PranavG200/ATV-BAJA-Team-Kinesis/Drivetrain.pdf

# Drivetrain

The drivetrain of a motor vehicle is the group of components that deliver power to the driving wheels. This excludes the engine that generates power. In contrast, the powertrain is considered to include both the engine and the drivetrain. The function of the drivetrain in a vehicle is to couple the engine that produces the power to the driving wheels that use this mechanical power to rotate the axle.

This connection involves the physical linkage of the two components, which might be at opposite ends of the vehicle hence requiring a long propeller shaft or drive shaft. The operating speed of the engine and wheels are also different and must be matched by the correct gear ratio. As the vehicle speed changes, the ideal engine speed must remain approximately constant for efficient operation and so this gearbox ratio must also be changed, either manually, automatically or by an automatic continuous variation.

Our power train assembly performance, are optimal for our event with maximum speed = 60.3 km/h , and further calculation can show we need the enlisted specifications to achieve the best relation.

Specifications:

Gear Ratio: | 10:1
Power to Mass Ratio : | 0.02 Hp/kg
Max Torque: | 18.57Nm @2600rpm
Max Power: | 7.5Hp@ 3600rpm (considering 25%loss)
Top Speed : | 60.372 kmph acceleration=0.98m/s^2

Inbuilt Locked Differential facilitate different power
requirements & smooth cornering.

Performance Characteristics:
The performance characteristics of BAJA vehicle strongly depends upon four main factors which are:
a.) Gradeability
b.) Top Speed
c.) Acceleration
d.) Reduction in lower gear ratio

Constant value:

For Gradeability:

Gradeability is defined as the ability of a vehicle to climb uphill at a certain angle without the slip occurring. It is an important factor that decides the maximum pulling force that can be applied by the engine on the wheels.

In general sense gradeability is defined in terms of percentage, let say X%. This means that vehicle will cover Xm distance in vertical direction while moving 100 m in a horizontal direction.

For getting an essence of this we try to calculate the variation in traction and various speeds, The following type of drag we need to understand first:

Rolling resistance:=
Rolling resistance is a result of energy loss in the tyre, which can be traced back to the deformation of the area of tyre contact and the damping properties of the rubber. These lead to the transformation of mechanical into thermal energy, contributing to warming of the tyre.

Aerodynamic Resistance:=
Aerodynamic drag of a vehicle is determined by the aerodynamic shape of the body, described by the drag coefficient(Cd), and by the projected frontal area of the vehicle(Af). The aerodynamic force increases with the square of the vehicle's velocity(v).

Grade Resistance:=
Grade resistance is the simplest form of resistance. It is the gravitational force acting on the vehicle. This force may not be exactly perpendicular to the roadway surface, especially in situations when an elevation is present.
Air density(⍴) | =1.12gm/cc
mass(m) (of buggy) | =250kg
Acceleration due to gravity(g) | =9.8m/s^2
Dynamic rolling friction(mr) | =0.085
Air Drag coefficient(cd) | =1.08
Frontal area(Ar) (of buggy) | =0.95m^2

For this calculation, formulae used are listed below:

Rolling resistance:=
mass x acceleration(gravity) x μ(friction coefficient) x Cos(angle of elevation)

Grade resistance:=
mass x acceleration(gravity) x Sin(angle of elevation)

Aerodynamic resistance:=
½ x ⍴(density of air) x A(frontal area) x V

2
(velocity of the buggy) x Cd(drag coefficient)

For calculating grade% of our buggy, we first try to analyze the variation of different speed and different grade%

Rolling resistance:

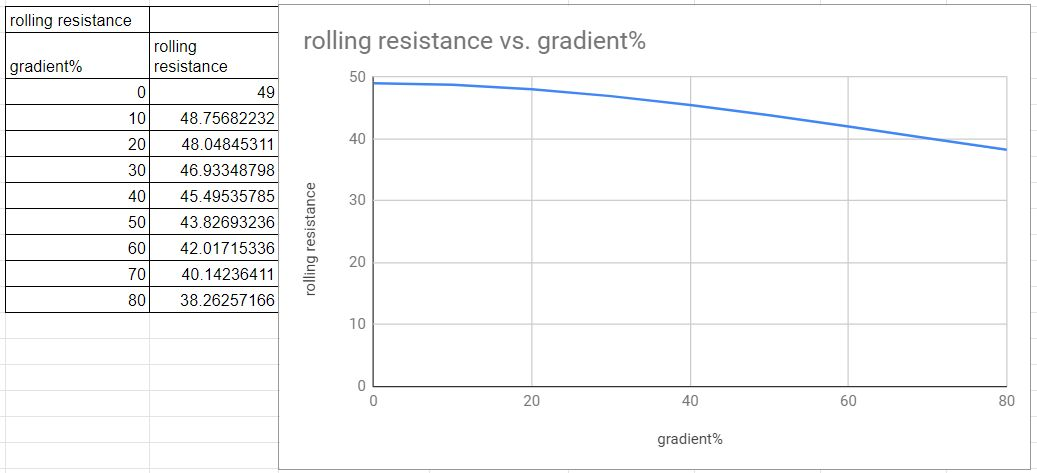
[picture p1: figure]

Gradient resistance:

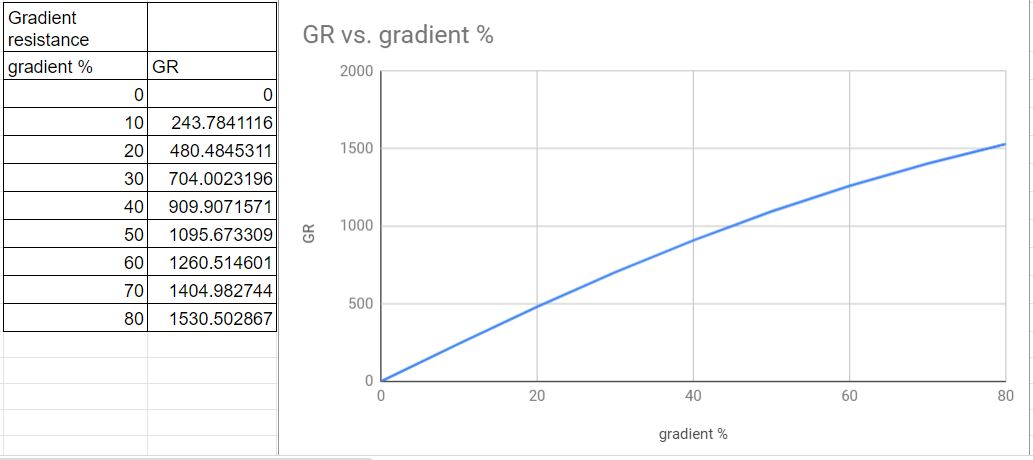
[picture p2: figure]

Aerodynamic resistance:

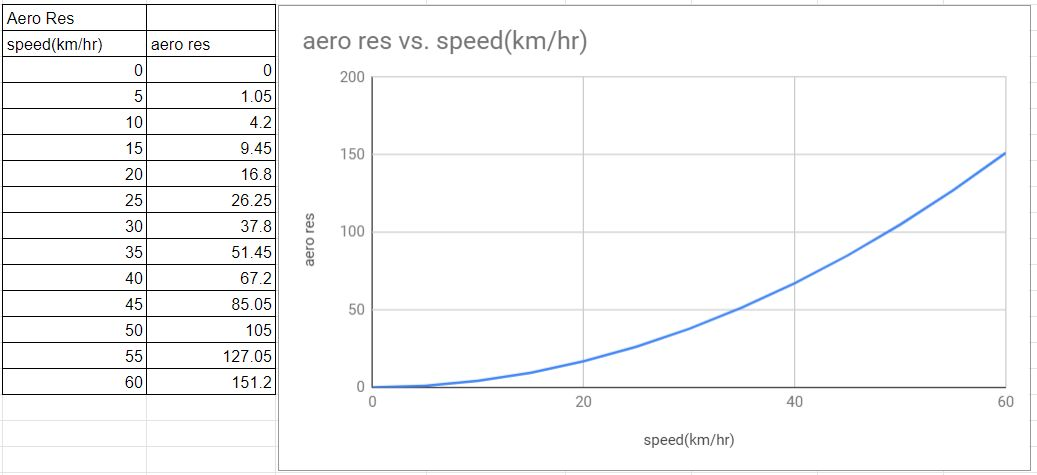
[picture p3: figure]

Total Tractive Effort:=
Total Tractive Effort is the net horizontal force applied by the drive wheels to the ground. If the design has two drive wheels, the force applied per drive wheel (for straight travel) is half of the calculated TTE. The total wheel torque does not change with the number of drive wheels. The sum of the individual drive motor torques must be greater than or equal to the computed Wheel Torque. The Maximum Tractive Torque represents the maximum amount of torque that can be applied before slipping occurs for each drive wheel. The total wheel torque must be less than the sum of the Maximum Tractive Torques for all drive wheels or slipping will occur.

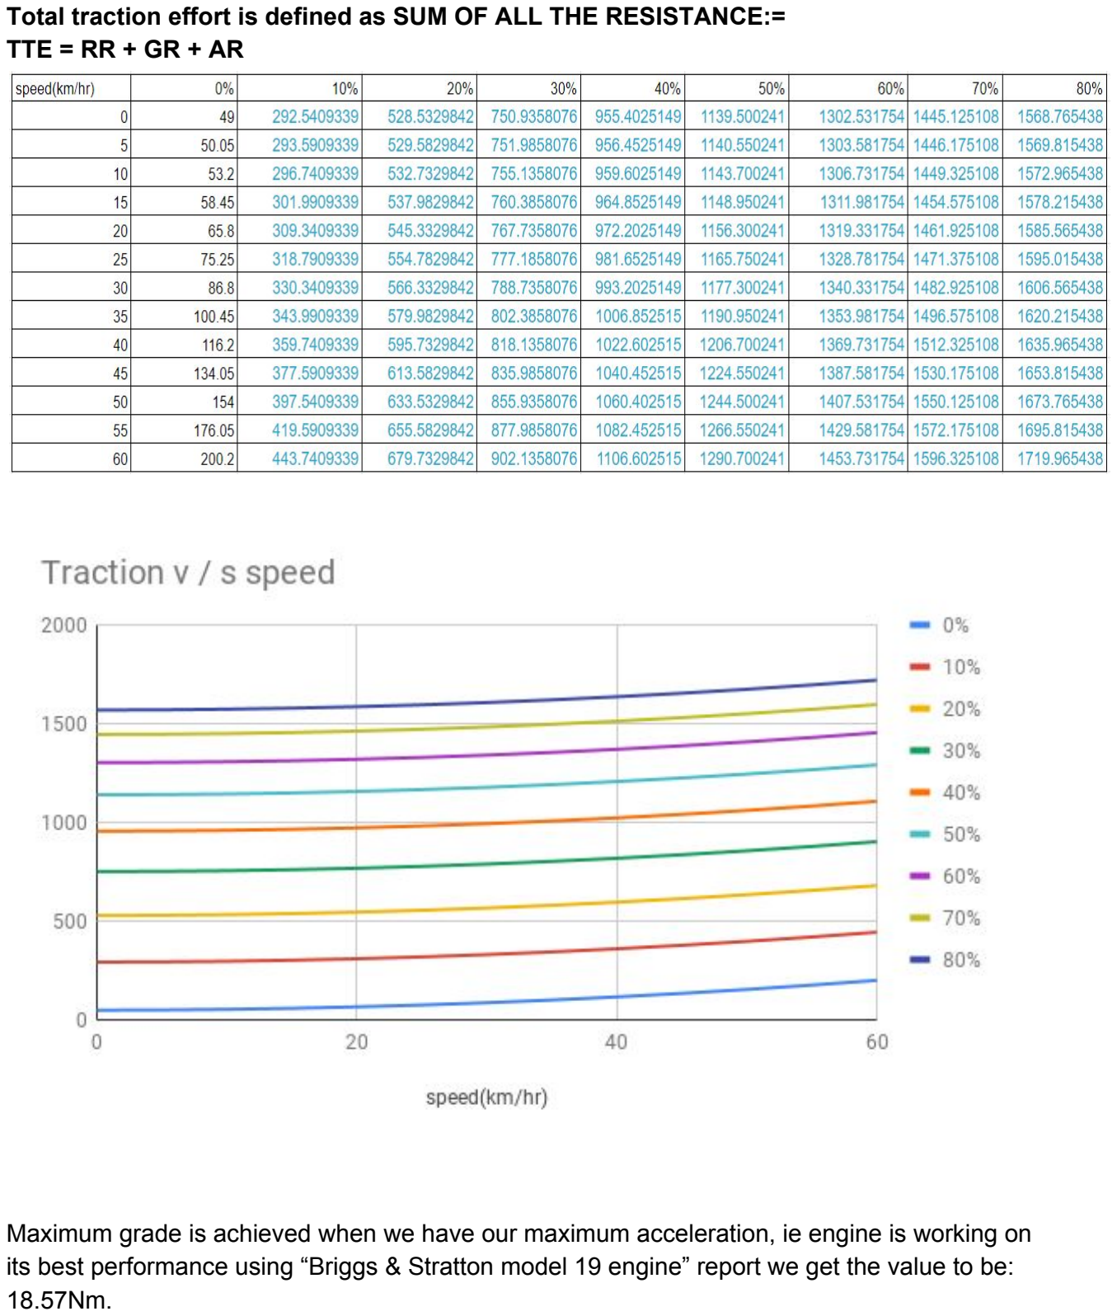
[picture p4: page 5]

Total traction effort is defined as SUM OF ALL THE RESISTANCE:= TTE = RR + GR + AR

Maximum grade is achieved when we have our maximum acceleration, ie engine is working on its best performance using “Briggs & Stratton model 19 engine” report we get the value to be: 18.57Nm.

For that particular torque vehicle, our vehicle achieves 3.362 m/s i.e. @ 12.096 Km/hr.

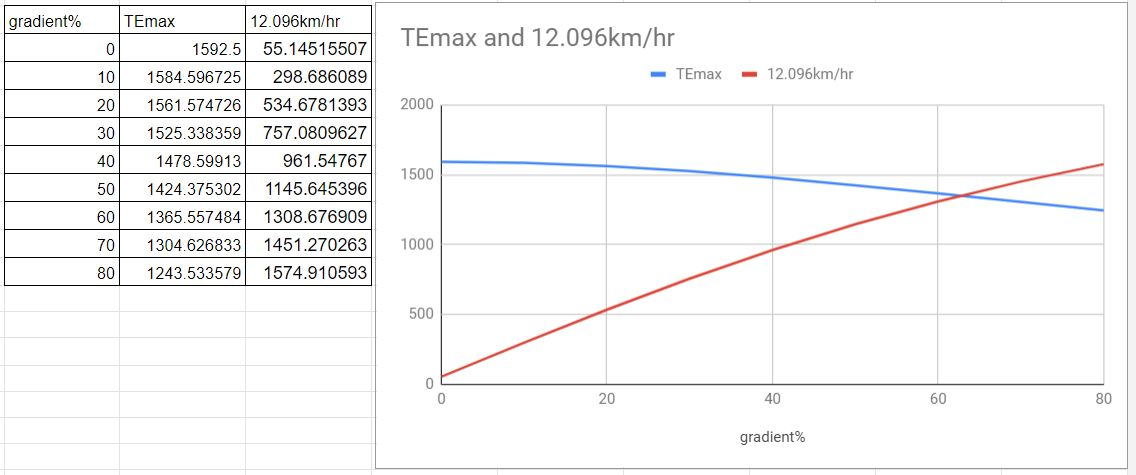
[picture p5: figure]

Using linear interpolation between gradient% of 60 and 70 we get the X(grade) and Y(N) as:
62.79 and 1348.54.

Greadiblity = 62.79.

### Maximum velocity:

Let the maximum velocity be V (m/s) Maximum output from the engine(max_eng)= 10hp =7457W

Maximum output at wheels(max_out)=

max_eng x (transmission efficiency)=
7457 x 0.7 =5219.9W

For maximum velocity net force on a body must be zero.

Therefore ,

Rolling resistance(RR)
= μ x m x g
= 0.09 x 250 x 9.8

=220.5 N

Aerodynamic resistance(AR) = ½ x ⍴x Ar x V

2x Cd
= 0.5 x 1.12 x 0.95 x 1.08 x V

2
= 0.57456 V

### 2 N

Total effort x V =5219.9 N

Net force = 0N

Power must be compensated by net resistive forces RR x V+AR x V=max_out
0.57456(V

3
) + 208.25V -5219.9=0

On solving

## V = 15.26m/s =54.93 km/hr

### Maximum acceleration :

Maximum acceleration will be achieved when there will be least resistance to the vehicle.

Let ‘a’ be the acceleration that we need to calculate.

For a body in motion:

Force = mass(m) x acceleration(a)

Te =18.66 N-m(Torque delivered by engine) Iglow = 30
Tw = Te * iglow *ηtransmission
(iglow is the overall reduction in low gear ηtransmission is the transmission efficiency ) Tw= 419.85 N-m (Torque @ wheels)

Pull at wheels,

Fw = Tw/dynamic radius of tire (Force @ wheels) Fw = 419.85/27.566 x 100N
Fw = 1523.07 N

Total Tractive effort required (TTE) = RR+ AR+GR

RR = 49N (dry road)
GR= m* g *sin(tan-1(0)
GR = 0 N (0% Gradient track)
AR=145.6870303
TTE=194.6870303

### a=(Fw-TTE)/m a=5.31 m/s^2

a = 5.31/9.8 g
= 0.541 g

### Reduction in LOWER GEAR RATIO:

Tw = (Total Road Load)* (dynamic rolling radius)

Tw = (1387.473)*(0.27566)
Tw= 387.65 N-m
Te = 18.66 N-m
ηtransmission=0.7

The relation between Torque@wheels and Tourque@engine is

Tw = Te* iglow * ηtransmission

iglow=Tw/(Te* ηtransmission )
=387.65/(18.66 * 0.7)
=29.688

Where,

iglow is the overall reduction in low gear ηtransmission is the transmission efficiency

We need to decide between CVtech and Gaged CVT.
Reduction for CVtech= | 29.688/3= | 9.89
Reduction for Gaged CVT= 29.688/3.9= 7.61

### RESULT:

Power train placement: the engine is placed in the rear part of the assembly. To balance the CG, we try to minimize the verticle placement of the engine and the CV points, further more we try to place the cvt casing and cv translation as to reduce the wheel base. We try different values of center to center distance that suits our conditions. To resolve the challenge of CVT mounting we final C-C distance as 231 mm.

# Engine Mounting Frame Dampers

The efficiency of vehicle gets reduced by the vibrations produced by the engine of the ATV. To increase the efficiency, we need to reduce NVH and for that we would be using rubber bushes as engine mounting frame dampers to effectively reduce the resulting NVH in the vehicle. The placement of rubber bushes is done at the point of engine mounting and reduction mounting in the presented vehicle.

Design Scheme:

Maximum velocity | 54.93 km/hr
Gradeability | 62.79
Reduction to be used | ● For CVTech = 9.81 = 10 approx ● For Gaged CVT=7.61= 8 approx
Maximum acceleration | 5.31 m/s^2

## CVT Casing

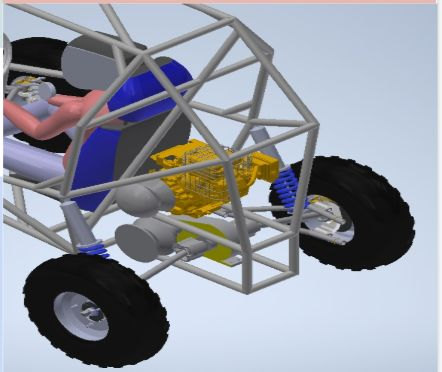
[picture p6: figure]

In order to prevent any external particle from hampering the smooth operation of our CVT and preventing the guard from getting injured due to rotating sheaves of the CVT we designed a cvt casing to house our transmission system using a 1.5mm thick AISI 1010 Steel sheet and abiding by the safety standards, the design is as follows.

In our previous year’s design, we had placed engine and CVT allignment as wheelbase was large enough. As to overcome that we had aligned the CVT and engine such that there is a reduction in wheelbase.

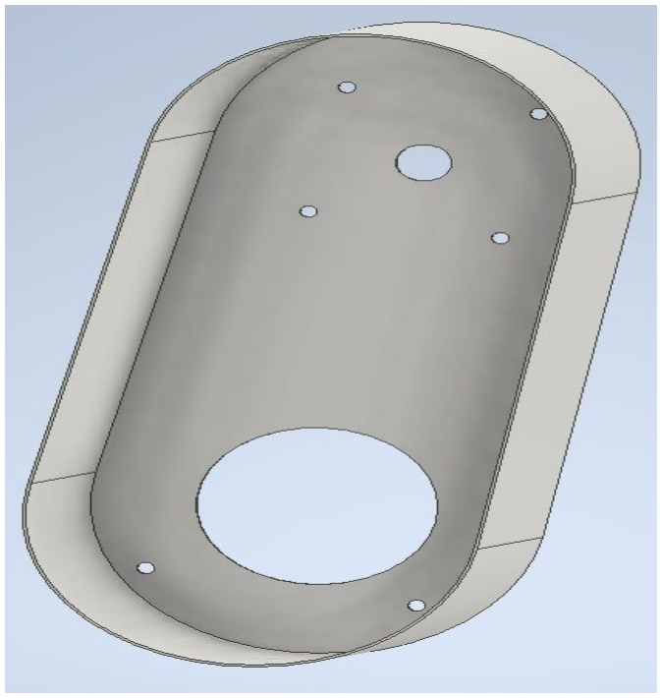
[picture p7: figure]
