PranavG200/ATV-BAJA-Team-Kinesis/(list of files, cad)

Other CAD files:
ANSI 1 x 0.133 00000006.0001.ipt
Assembly_my.iam
